r0the/pinball/README.md

# Ausgabemodule für Flipperautomaten

Für das Fakultativfach *Technisches Konstruieren* am [Gymnasium Kirchenfeld](https://www.gymkirchenfeld.ch/), in welchem Schülerinnen und Schüler einen Flipperautomaten bauen, entwickle ich elektronische Anzeigemodule. Kern der Module bildet ein
[Arduino](https://www.arduino.cc/)-Mikrocontroller-Board.

## Funktionalität

Die Module bieten die folgende Funktionalität:

- Zählen der Punkte
- Anzeige des aktuellen Punktestands
- Abspielen von Audiodateien
- Speichern des Punktehöchststands (Highscore)
- Steuerung von Lampen oder Leuchtdioden des Automaten
- Anzeige eines Lauftextes (nur Modul B)

## Varianten

Es gibt zwei Varianten, welche sich in der Art des Displays unterscheiden.

- Das **Variante A** verwendet zur Anzeige des Punktestands fünf LED-Segmentanzeigen.
- Das **Variante B** stellt Punktestand und allenfalls weitere Informationen auf einer oder mehreren
  LED-Matrixanzeigen dar.

Zur Zeit steht pro Jahrgang steht nur eine Variante zu Verfügung.
