r0the/pinball/2015/images/spi.pdf

SPI Master; SCK MOSI MISO CS; SPI Slave
