r0the/pinball/2015/images/schraubklemme.jpg

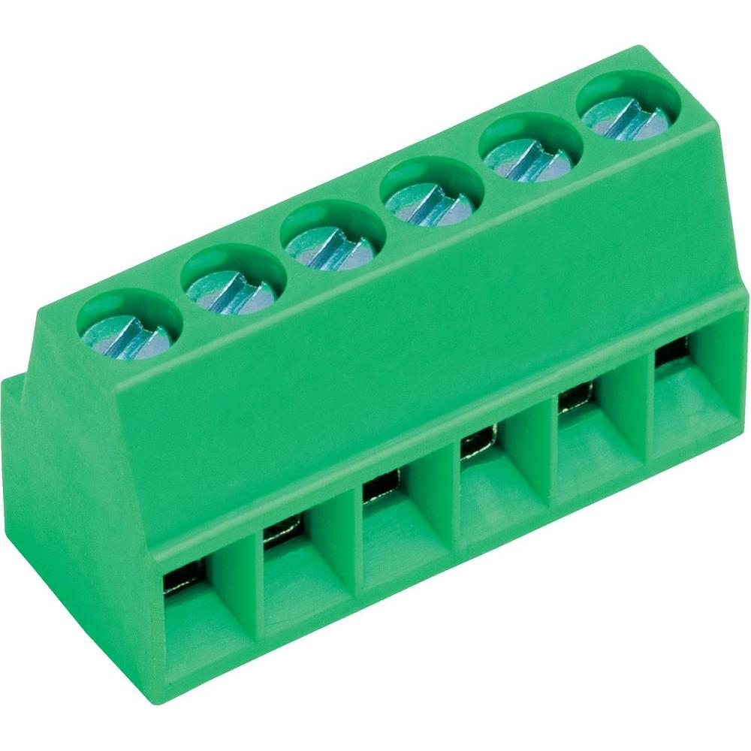
2015/images/schraubklemme.jpg
