r0the/pinball/2015/images/wannenstiftleiste.jpg

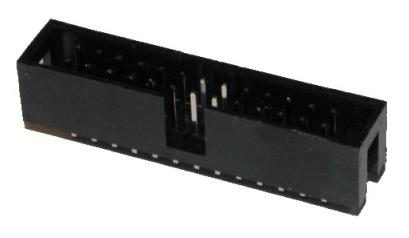
2015/images/wannenstiftleiste.jpg
