r0the/pinball/images/shield-2016-back-bare.jpg

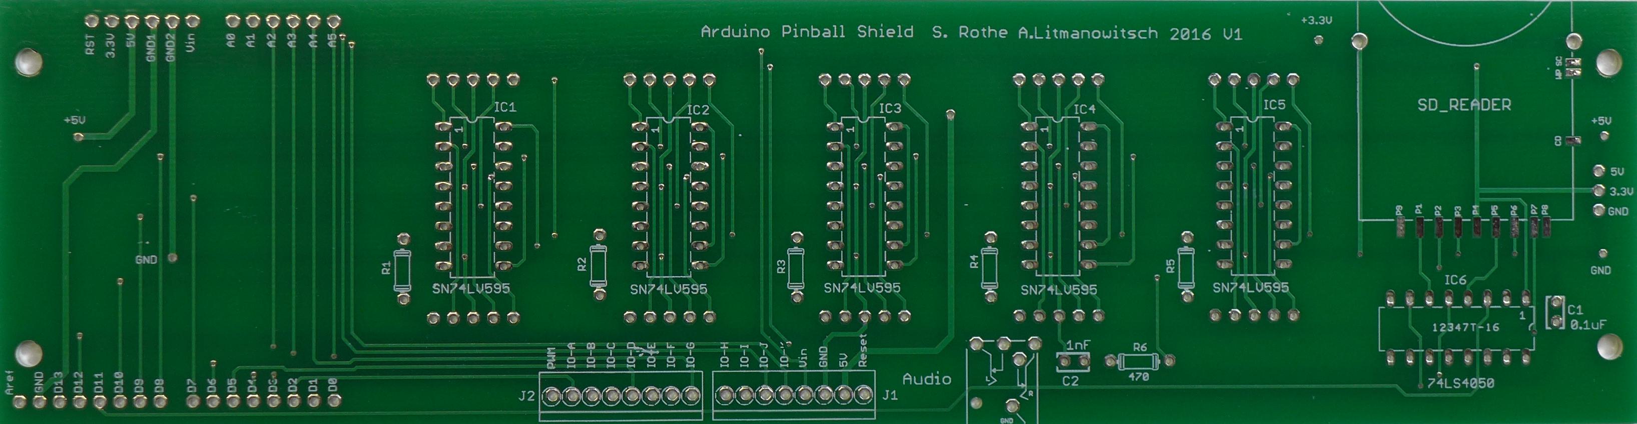
images/shield-2016-back-bare.jpg
