r0the/pinball/images/shield-2016-back-sd-reader.jpg

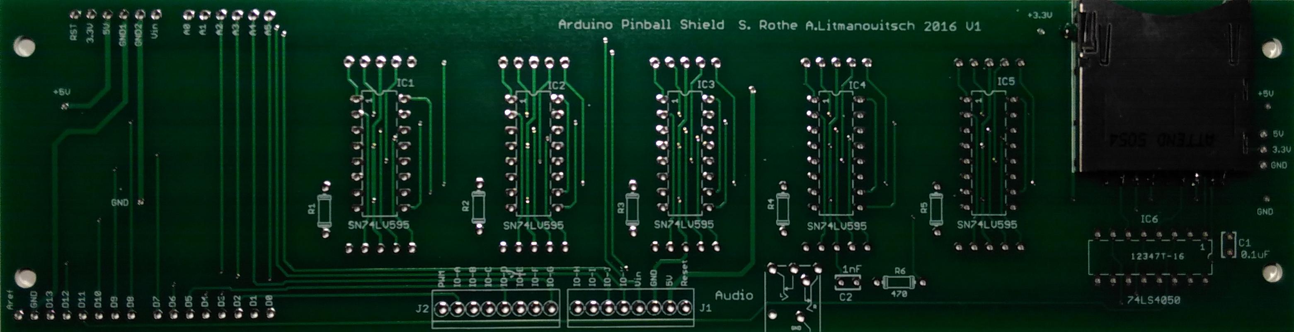
images/shield-2016-back-sd-reader.jpg
