r0the/pinball/images/shield-2016-front-bare.jpg

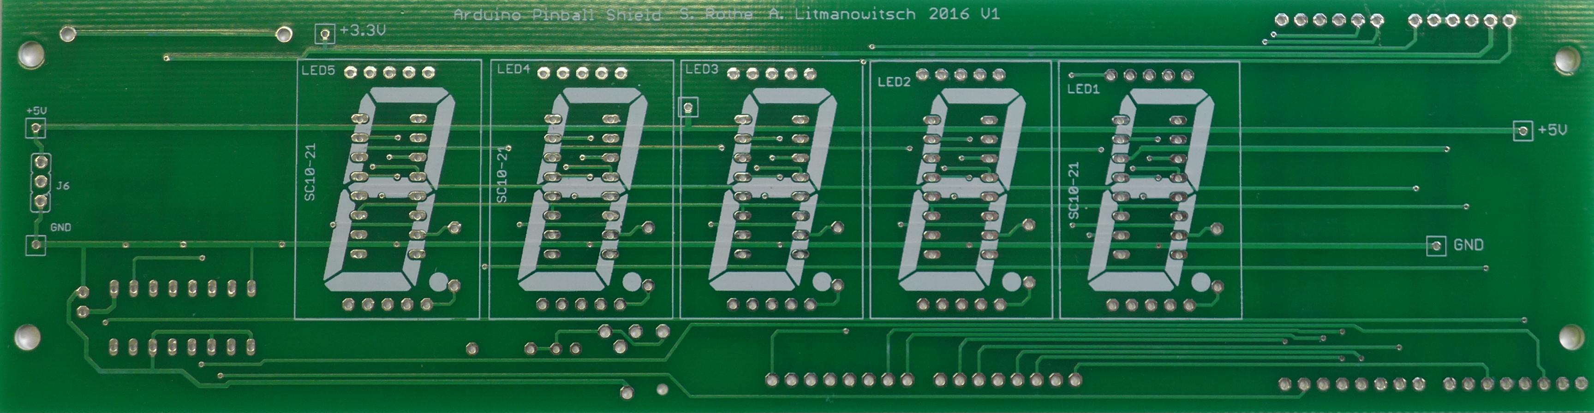
images/shield-2016-front-bare.jpg
