r0the/pinball/images/shield-2016-front-populated.png

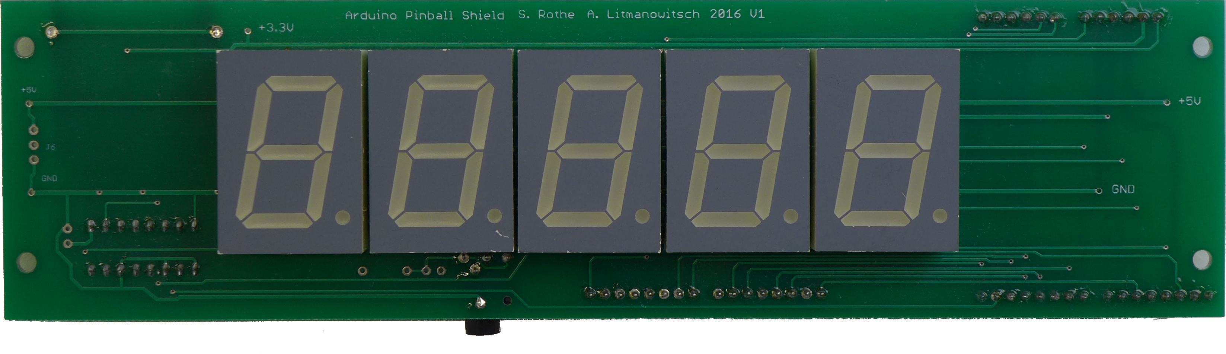
images/shield-2016-front-populated.png
