r0the/pinball/presentation/images/amplifier.png

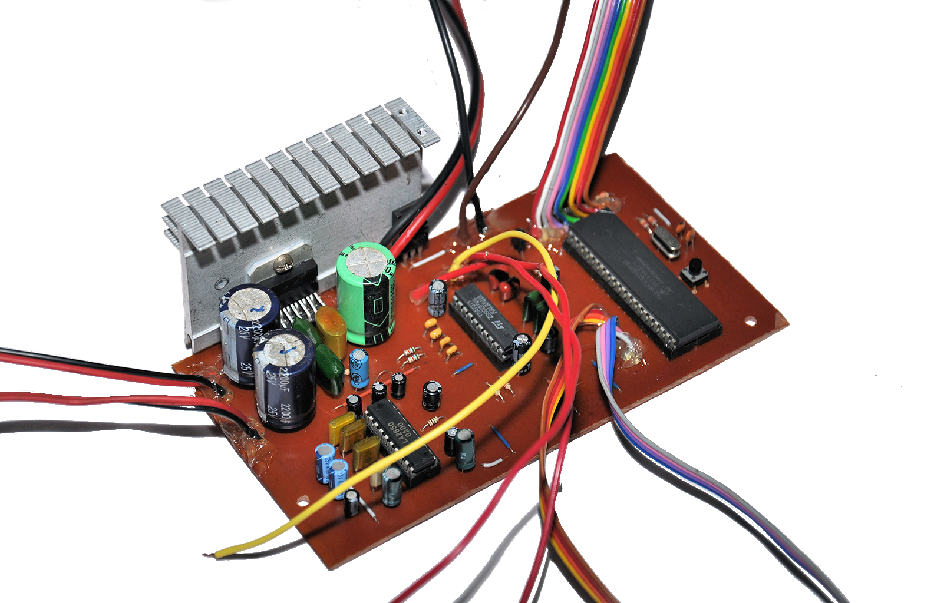
presentation/images/amplifier.png
