r0the/pinball/presentation/images/arduino-duemilanove.png

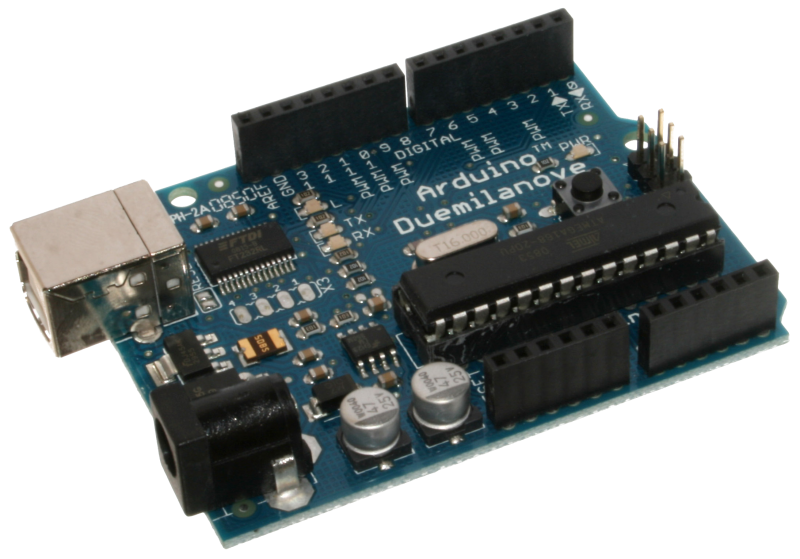
presentation/images/arduino-duemilanove.png
