r0the/pinball/presentation/images/bernmobil.jpg

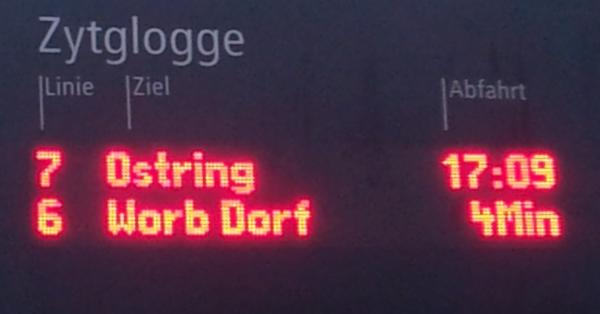
presentation/images/bernmobil.jpg
