r0the/pinball/presentation/images/dot-matrix.gif

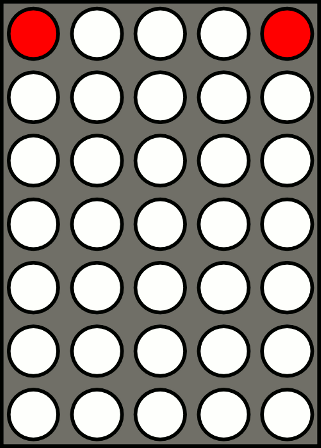
presentation/images/dot-matrix.gif
