r0the/pinball/presentation/images/led-matrix.jpg

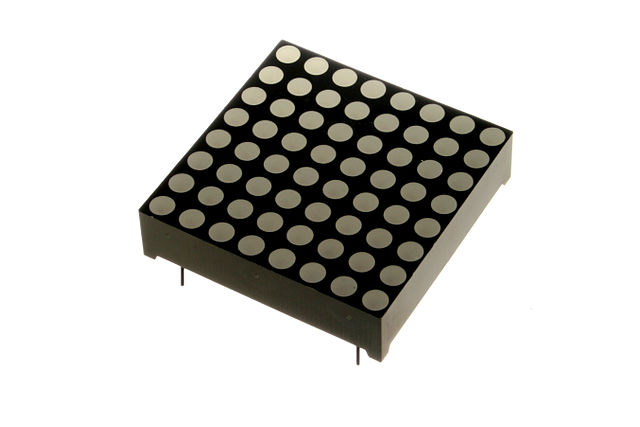
presentation/images/led-matrix.jpg
