r0the/pinball/presentation/images/mac-book.png

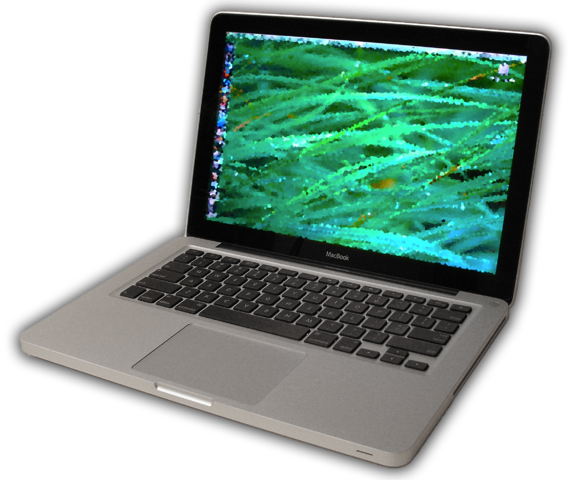
presentation/images/mac-book.png
