r0the/pinball/presentation/images/raspberry-pi.png

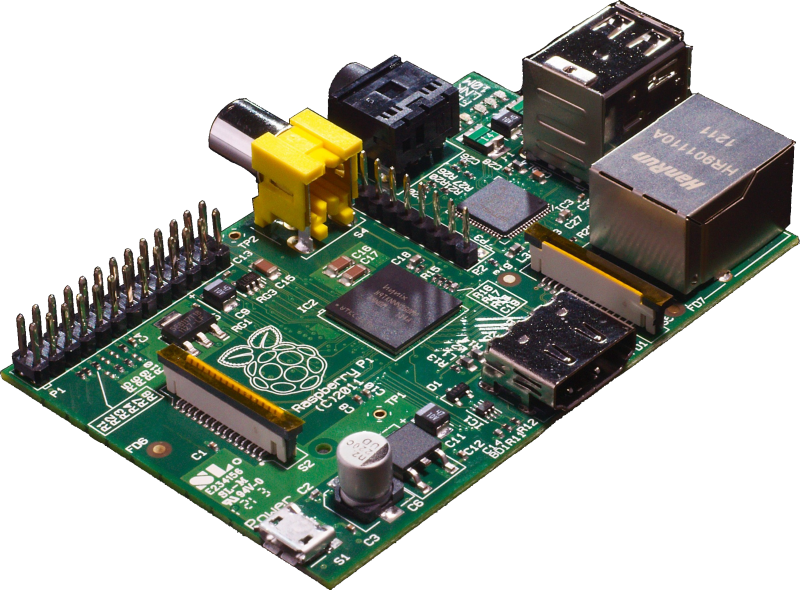
presentation/images/raspberry-pi.png
