r0the/pinball/presentation/images/sd-card.png

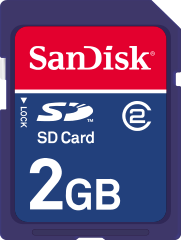
presentation/images/sd-card.png
