r0the/pinball/presentation/images/shield-2016-back-arduino.png

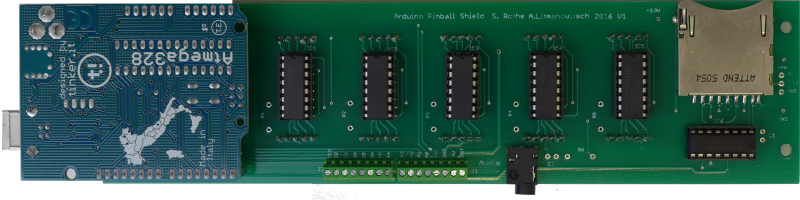
presentation/images/shield-2016-back-arduino.png
