r0the/pinball/presentation/images/shield-2016-back-bare.jpg

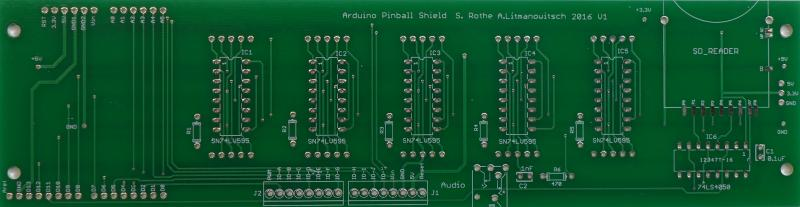
presentation/images/shield-2016-back-bare.jpg
