r0the/pinball/presentation/images/shield-2016-back-populated.png

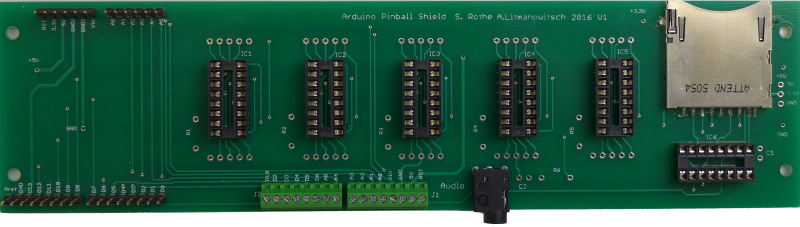
presentation/images/shield-2016-back-populated.png
