r0the/pinball/presentation/images/usb-speaker.png

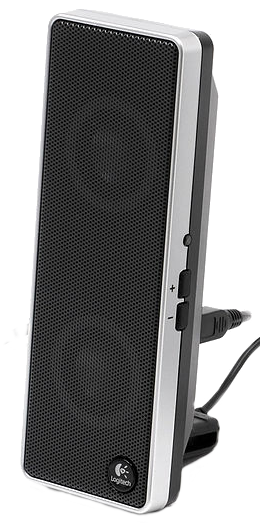
presentation/images/usb-speaker.png
