r0the/pinball/presentation/sample-resources/sample.jpg

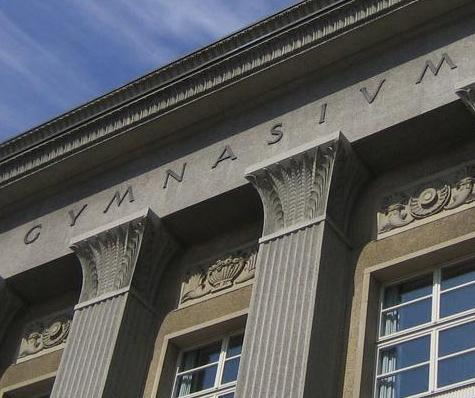
presentation/sample-resources/sample.jpg
