r0the/pinball/presentation/images/assembly-line.jpg

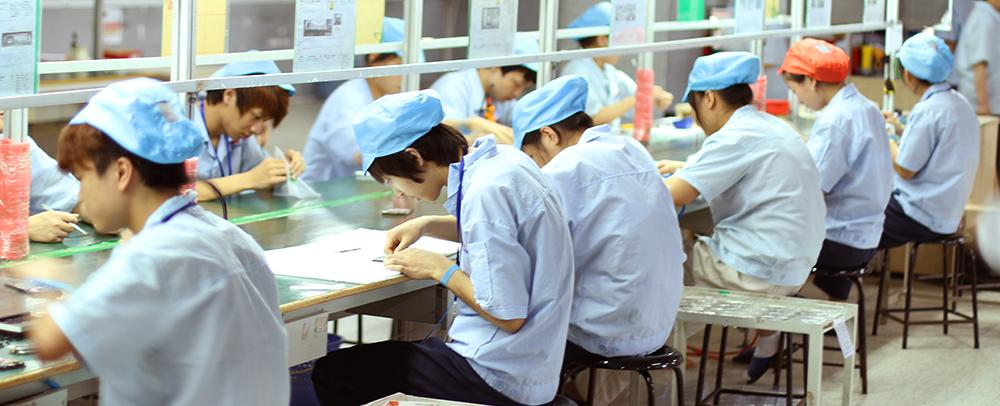
presentation/images/assembly-line.jpg
