r0the/pinball/shield-a/pinball-shield-2016-schema.pdf

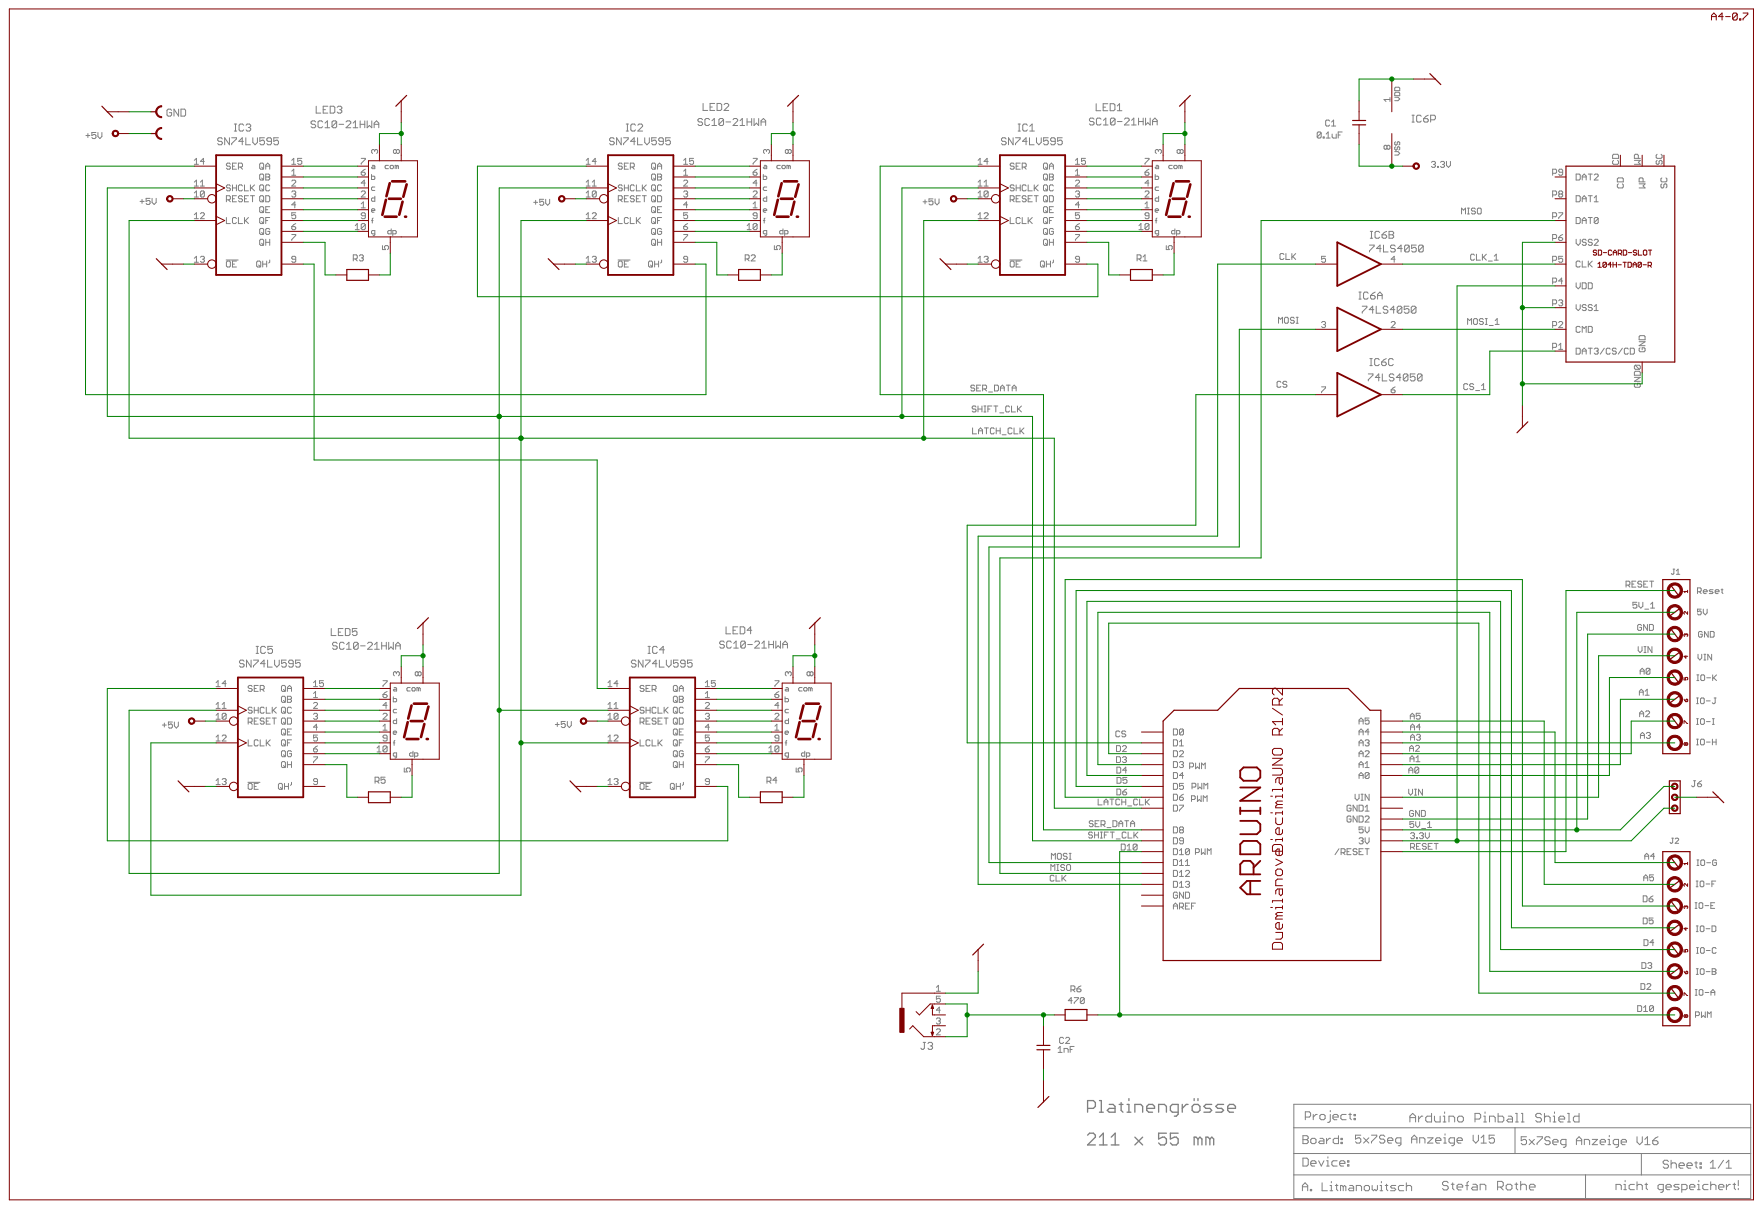
[picture p37: page 1]
