r0the/pinball/shield-a/pinball-shield-2016-board.pdf

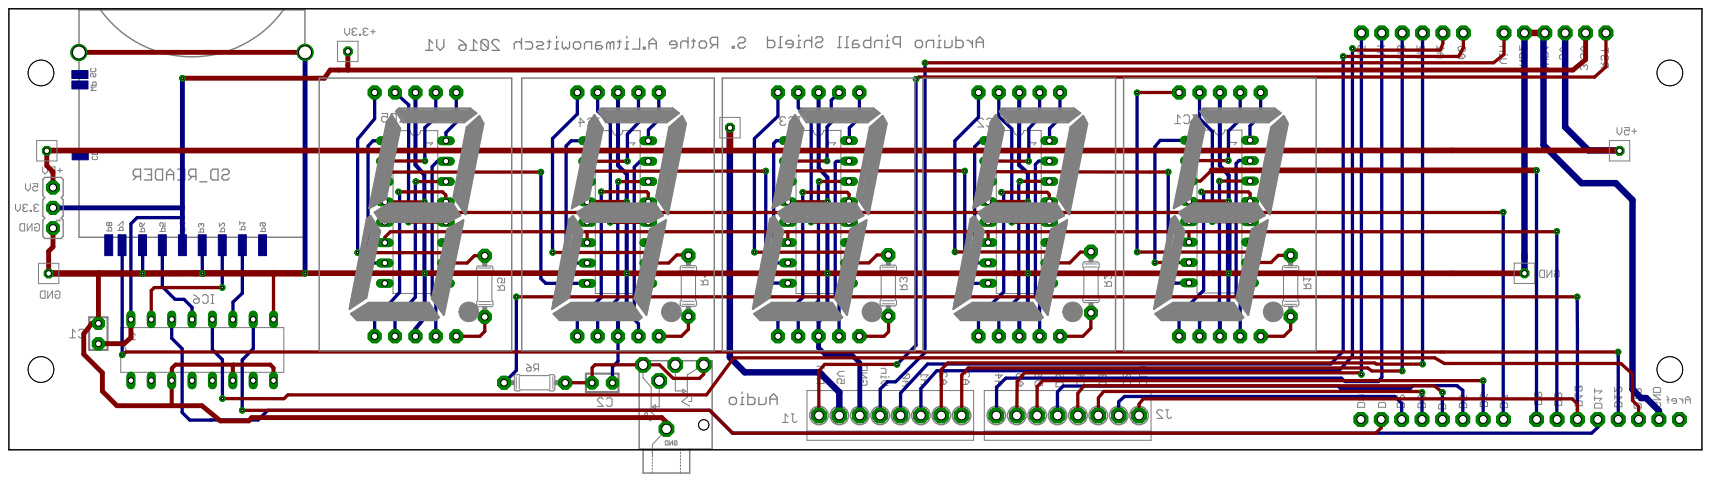
[picture p38: page 1]
