r0the/pinball/shield-a/pinball-shield-2016.brd

## EAGLE design shield-a/pinball-shield-2016.brd (2015-12-27)

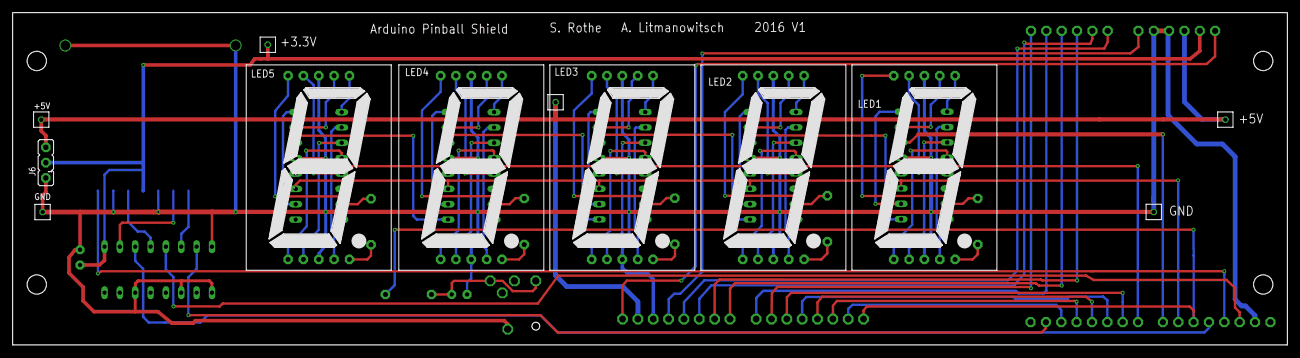
[picture p39: board pinball-shield-2016.brd from above]

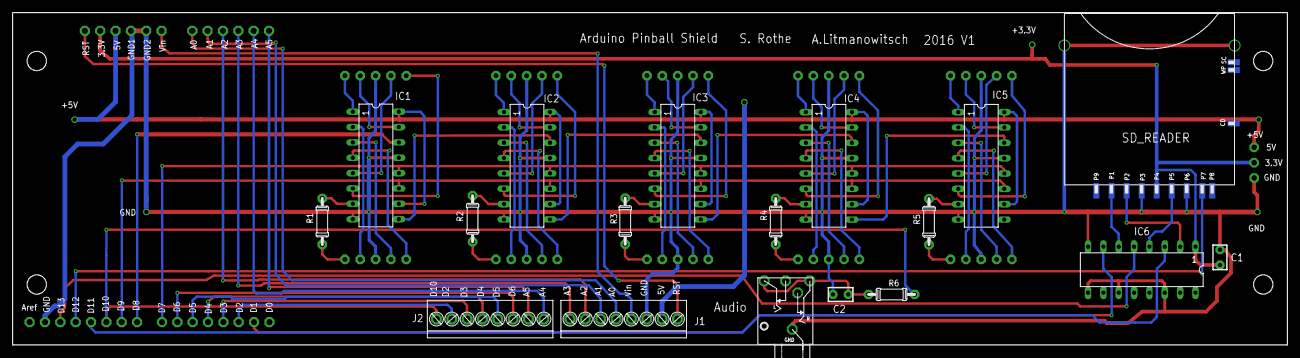
[picture p40: board pinball-shield-2016.brd from below]

Board: 2 copper layers, 211.0 x 55.0 mm, 58 parts (18 on the bottom side), 77 nets.

Parts:
C1: 0.1uF; 02P101QK
C2: 1nF; 02P101QK
E$1: JACK_CONRAD_730294
E$2, E$3, E$4, E$5, E$8, E$9, E$10, E$12, E$13, E$14, E$15, E$16, E$17, E$18, E$19, E$20, E$21, E$22, E$23, E$24, E$25, E$26, E$27, E$28, E$29, E$30, E$31, E$32: DRILL040
E$6, E$7, E$11, E$33, E$34, E$35: CON01_FOR_AT2560_ALIT
IC1, IC2, IC3, IC4, IC5: SN74LV595; DIL16
IC6: 74LS4050; DIL16
J1, J2: PH2_54X8
J6: JP2
LED1, LED2, LED3, LED4, LED5: SC10-21; 7SEG-2.54
R1, R2, R3, R4, R5: 0204/7
R6: 470; 0204/7
SD_READER: 104H-TDA0-R

Connections:
3.3V: C1.2, E$14.P$1, E$35.1, IC6.1, J6.2, SD_READER.P4
+5V: E$7.1, E$11.1, E$15.P$1, E$34.1, IC1.10, IC1.16, IC2.10, IC2.16, IC3.10, IC3.16, IC4.10, IC4.16, IC5.10, IC5.16, J1.7, J6.3
GND: C1.1, C2.2, E$1.1, E$3.P$1, E$6.1, E$16.P$1, E$17.P$1, E$33.1, IC1.8, IC1.13, IC2.8, IC2.13, IC3.8, IC3.13, IC4.8, IC4.13, IC5.8, IC5.13, IC6.8, IC6.9, IC6.11, IC6.14, J1.6, J6.1, LED1.3, LED1.8, LED2.3, LED2.8, LED3.3, LED3.8, LED4.3, LED4.8, LED5.3, LED5.8, SD_READER.GND0, SD_READER.GND1, SD_READER.P3, SD_READER.P6
unnamed: IC4.15, LED4.7
unnamed: IC4.1, LED4.6
unnamed: IC4.2, LED4.4
unnamed: IC4.3, LED4.2
unnamed: IC4.4, LED4.1
unnamed: IC4.5, LED4.9
unnamed: IC4.6, LED4.10
unnamed: IC4.7, R4.2
unnamed: LED4.5, R4.1
unnamed: IC3.15, LED3.7
unnamed: IC3.1, LED3.6
unnamed: IC3.2, LED3.4
unnamed: IC3.3, LED3.2
unnamed: IC3.4, LED3.1
unnamed: IC3.5, LED3.9
unnamed: IC3.6, LED3.10
unnamed: IC3.7, R3.2
unnamed: LED3.5, R3.1
unnamed: IC2.15, LED2.7
unnamed: IC2.1, LED2.6
unnamed: IC2.2, LED2.4
unnamed: IC2.3, LED2.2
unnamed: IC2.4, LED2.1
unnamed: IC2.5, LED2.9
unnamed: IC2.6, LED2.10
unnamed: IC2.7, R2.2
unnamed: LED2.5, R2.1
unnamed: IC1.15, LED1.7
unnamed: IC1.1, LED1.6
unnamed: IC1.2, LED1.4
unnamed: IC1.3, LED1.2
unnamed: IC1.4, LED1.1
unnamed: IC1.5, LED1.9
unnamed: IC1.6, LED1.10
unnamed: IC1.7, R1.2
unnamed: LED1.5, R1.1
unnamed: IC5.15, LED5.7
unnamed: IC5.1, LED5.6
unnamed: IC5.2, LED5.4
unnamed: IC5.3, LED5.2
unnamed: IC5.4, LED5.1
unnamed: IC5.5, LED5.9
unnamed: IC5.6, LED5.10
unnamed: IC5.7, R5.2
unnamed: LED5.5, R5.1
S$1: E$10.P$1, IC1.11, IC2.11, IC3.11, IC4.11, IC5.11
S$2: E$25.P$1, IC1.12, IC2.12, IC3.12, IC4.12, IC5.12
S$3: E$12.P$1, IC1.14
S$4: IC1.9, IC2.14
S$5: IC2.9, IC3.14
S$6: IC3.9, IC4.14
S$7: IC4.9, IC5.14
S$8: E$13.P$1, J1.8
S$10: C2.1, E$1.2, E$1.5, R6.1
S$12: E$18.P$1, J1.5
S$13: E$19.P$1, J1.4
S$14: E$20.P$1, J1.3
S$15: E$21.P$1, J1.2
S$16: E$22.P$1, J1.1
S$17: E$29.P$1, J2.3
S$18: E$27.P$1, J2.5
S$19: E$26.P$1, J2.6
S$21: E$30.P$1, J2.2
S$22: E$24.P$1, J2.7
S$23: E$28.P$1, J2.4
S$24: E$23.P$1, J2.8
S$25: E$31.P$1, IC6.7
S$26: E$8.P$1, IC6.3
S$27: E$4.P$1, IC6.5
S$28: E$5.P$1, SD_READER.P7
S$29: IC6.6, SD_READER.P1
S$30: IC6.2, SD_READER.P2
S$31: IC6.4, SD_READER.P5
S$35: E$9.P$1, J2.1, R6.2
