r0the/pinball/2015/module_b_2015/virtual_display.cpp

/*
 * Copyright (C) 2014 - 2015 by Stefan Rothe
 *
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
 * You should have received a copy of the GNU Lesser General Public License
 * along with this program.  If not, see <http://www.gnu.org/licenses/>.
 */
 
 #include "virtual_display.h"

#define MAX_DISPLAY_COUNT 4

#define DISPLAY_WIDTH 32

PROGMEM const byte FONT[] PROGMEM = {
    B00000000, B00000000, B00000000, B00000000, B00000000, 3, // SPACE
    B01011111, B00000000, B00000000, B00000000, B00000000, 1, // !
    B00000011, B00000000, B00000011, B00000000, B00000000, 3, // "
    B00010100, B01111111, B00010100, B01111111, B00010100, 5, // #
    B00100100, B00101010, B01101011, B00101010, B00010010, 5, // $
    B00100011, B00010011, B00001000, B01100100, B01100010, 5, // %
    B00000000, B00000000, B00000000, B00000000, B00000000, 0, // & TODO
    B00000011, B00000000, B00000000, B00000000, B00000000, 1, // '

    B00011100, B00100010, B01000001, B00000000, B00000000, 3, // (
    B01000001, B00100010, B00011100, B00000000, B00000000, 3, // )
    B00101010, B00011100, B00111110, B00011100, B00101010, 5, // * IMPROVE
    B00001000, B00001000, B00111110, B00001000, B00001000, 5, // +
    B10000000, B01000000, B00000000, B00000000, B00000000, 2, // ,
    B00001000, B00001000, B00001000, B00001000, B00001000, 5, // -
    B01000000, B01000000, B00000000, B00000000, B00000000, 1, // .
    B00100000, B00010000, B00001000, B00000100, B00000010, 5, // /

    B00111110, B01010001, B01001001, B01000101, B00111110, 5, // 0
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
    B00111000, B01000100, B01000100, B01000100, B00111000, 5, // o
    B11111100, B00100100, B00100100, B00100100, B00011000, 5, // p
    B00011000, B00100100, B00100100, B00100100, B11111100, 5, // q
    B00000100, B01111000, B00000100, B00000100, B00001000, 5, // r
    B01001000, B01010100, B01010100, B01010100, B00100100, 5, // s
    B00000100, B00111111, B01000100, B01000100, B00000000, 4, // t
    B00111100, B01000000, B01000000, B01000000, B01111100, 5, // u
    B00001100, B00110000, B01000000, B00110000, B00001100, 5, // v
    B00111100, B01000000, B00111100, B01000000, B00111100, 5, // w
    B01000100, B00101000, B00010000, B00101000, B01000100, 5, // x
    B00011100, B10100000, B10100000, B10100000, B01111100, 5, // y
    B01000100, B01100100, B01010100, B01001100, B01000100, 5, // z
    B00001000, B00110110, B01000001, B01000001, B00000000, 4, // {
    B01111111, B00000000, B00000000, B00000000, B00000000, 1, // |
    B01000001, B01000001, B00110110, B00001000, B00000000, 4, // }
    B00000010, B00000001, B00000010, B00000001, B00000000, 4, // ~
};

#define CHAR_BYTES 6
#define MIN_CHAR 32
#define MAX_CHAR 126

byte readFont(char ch, int offset) {
    if (MIN_CHAR <= ch && ch <= MAX_CHAR) {
        return pgm_read_byte_near(FONT + (ch - MIN_CHAR) * CHAR_BYTES + offset);
    }
    else {
        return 0;
    }
}

VirtualDisplay::VirtualDisplay() {
    _displayCount = 0;
    _displays = new const SureDisplay*[MAX_DISPLAY_COUNT];
    clear();
}

void VirtualDisplay::addDisplay(const SureDisplay* display) {
    if (_displayCount < MAX_DISPLAY_COUNT) {
        _displays[_displayCount] = display;
        ++_displayCount;
    }
}

void VirtualDisplay::clear() {
    for (int pos = 0; pos < _displayCount * DISPLAY_WIDTH; ++pos) {
        setColumn(pos, 0);
    }
}

int VirtualDisplay::displayWidth() const {
    return _displayCount * DISPLAY_WIDTH;
}

void VirtualDisplay::setColumn(int pos, byte data) {
    if (0 <= pos && pos < DISPLAY_WIDTH * _displayCount) {
        _displays[pos / DISPLAY_WIDTH]->setColumn(pos % DISPLAY_WIDTH, data);
    }
}

void VirtualDisplay::showNumber(unsigned long number, byte width) {
    int pos = writeNumber(DISPLAY_WIDTH * _displayCount - 1, number, width);
    for (int i = 0; i < pos; ++i) {
        setColumn(i, 0);
    }
}

int VirtualDisplay::textWidth(const char* text) const {
    int result = 0;
	int i = 0;
    while (text[i] != '\0') {
        result += readFont(text[i], CHAR_BYTES - 1) + 1;
        ++i;
    }

    return result - 1;
}

int VirtualDisplay::write(int pos, const char* text) {
    int i = 0;
    while (text[i] != '\0') {
        pos = writeChar(pos, text[i], LR);
        ++i;
    }

    return pos;
}

int VirtualDisplay::writeChar(int pos, char ch, boolean direction) {
    int charWidth = readFont(ch, CHAR_BYTES - 1);
    if (direction == LR) {
        for (int i = 0; i < charWidth; ++i) {
            setColumn(pos, readFont(ch, i));
            ++pos;
        }

        setColumn(pos, 0);
        return pos + 1;
    }
    else {
        for (int i = charWidth - 1; i >= 0; --i) {
            setColumn(pos, readFont(ch, i));
            --pos;
        }

        setColumn(pos, 0);
        return pos - 1;
    }
}

int VirtualDisplay::writeNumber(int pos, unsigned long number, byte width) {
    int w = 0;
	while (number > 0) {
        pos = writeChar(pos, '0' + number % 10, RL);
        ++w;
        number = number / 10;
    }

    while (w < width) {
        pos = writeChar(pos, '0', RL);
        ++w;
    }

    return pos;
}
