r0the/pinball/(commit log)

2015-12-22 Fixed: Show demo text on reset.
    [module_b_2015.ino]
2015-12-23 Fixed: resetting number parameter when parsing multiple commands.
    [module_b_2015.ino]
2015-12-27 Added pinball shield 2016 schematics.
    [pinball-shield-2016-v1.brd, pinball-shield-2016-v1.sch]
2016-01-18 Fixed bug in command interpreter. 'b' and 'x' are now executed correctly.
    [module_b_2015.ino]
2016-01-27 Added init event 6 seconds after game over, fixed high score event.
    [module_b_2015.ino]
2016-03-16 2015 - Improved input signal detection: don't trigger on short peaks.
    [pins.cpp]
2016-03-16 2015 - Fixed custom code (Noell).
    [custom_noell.h]
2016-06-09 Working audio output on pin 10.
2016-06-21 Renamed schema files.
    [pinball-shield-2016.brd, pinball-shield-2016.sch]
2016-08-25 2016 Release 2
    - Changed variable names
    - Added countdown events
    - Fixed bugs
    [Arduino.cpp, Arduino.h, SD.h, audio.cpp, audio.h, consts.h, display.cpp, display.h]
2016-11-04 Fixed duplicate calling of events.
    [module_a_2016.ino]
2017-01-14 Fixed large number problem.
    [consts.h]
2017-01-14 Now 1 maps correctly to HIGH output, 0 to LOW.
    [vars.cpp]
2017-01-25 Enhanced documentation: RGB LED stripe, programming of special mode
2017-01-25 Improved image of relay
2017-01-31 Added support for Nixie tube display.
